Harrisonust/STM32Keyboard/doc/images/keyboard_view.jpg

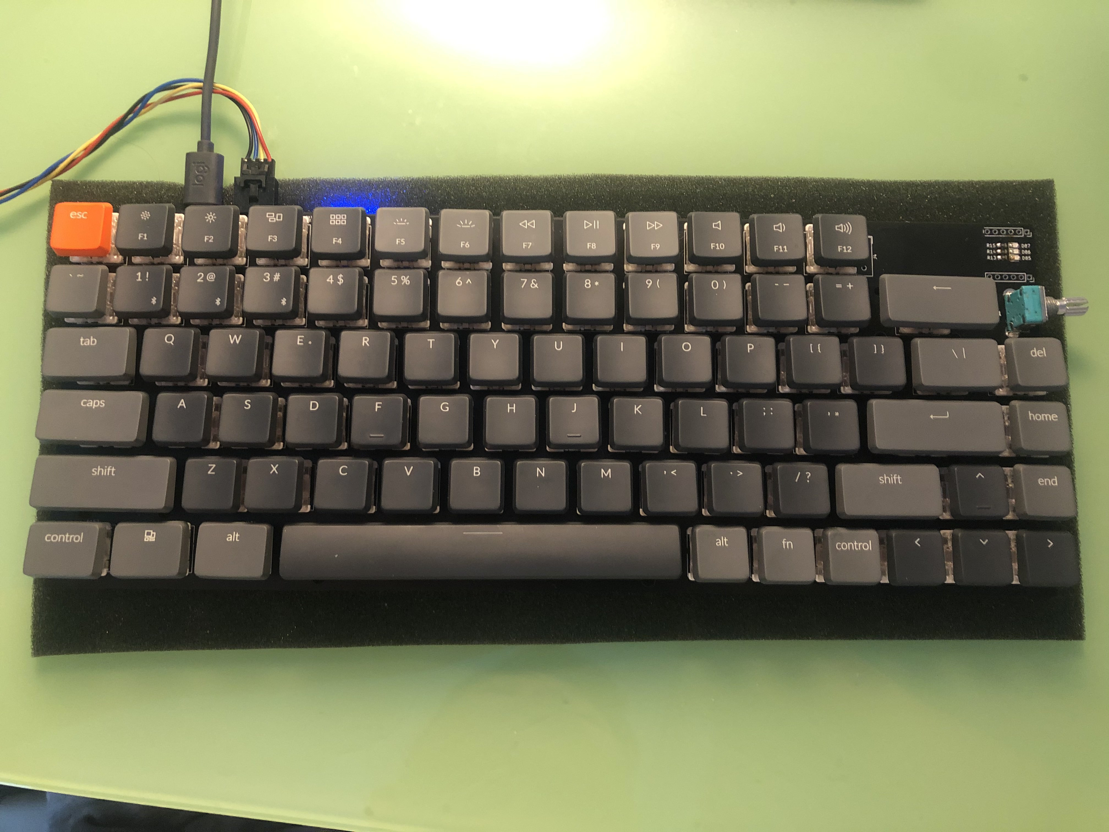
doc/images/keyboard_view.jpg
