Harrisonust/STM32Keyboard/doc/images/kicad-3dview-back.png

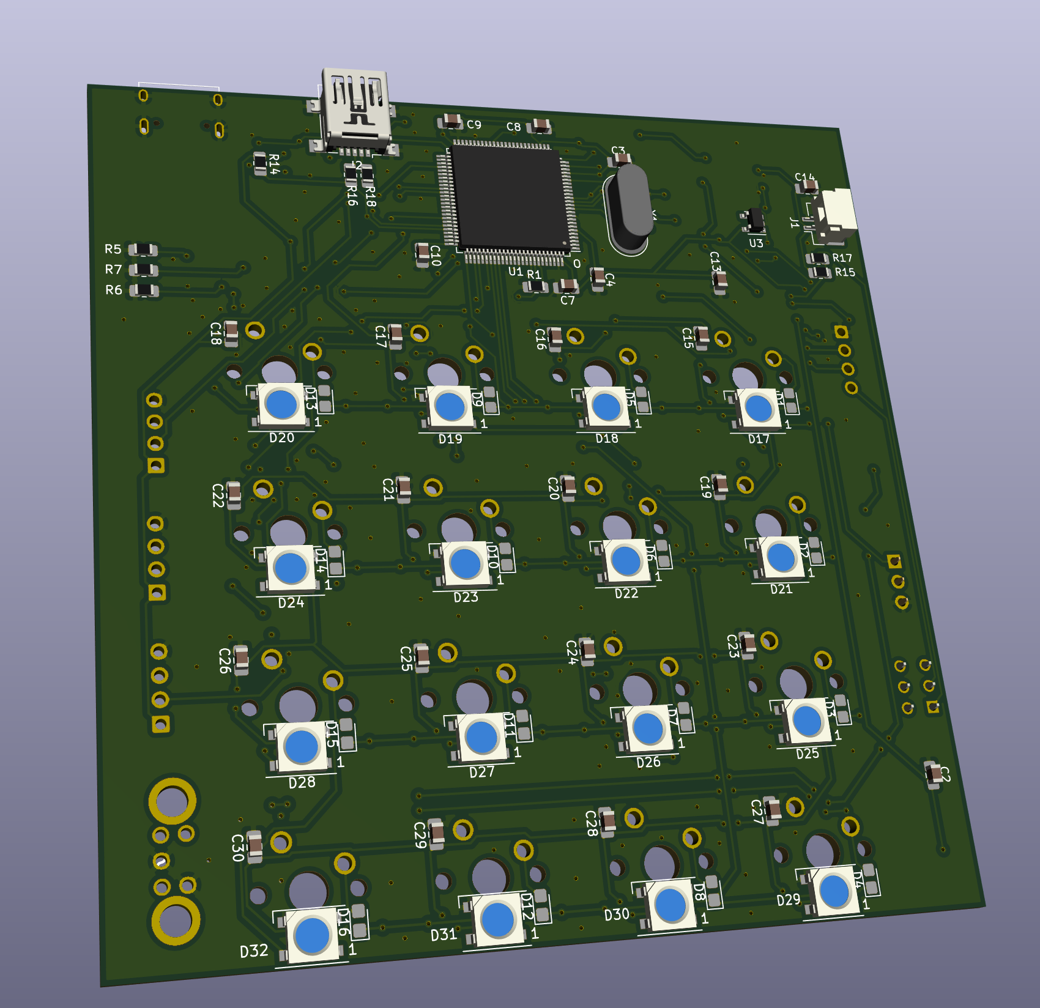
doc/images/kicad-3dview-back.png
