Harrisonust/STM32Keyboard/doc/images/kicad-3dview-front.png

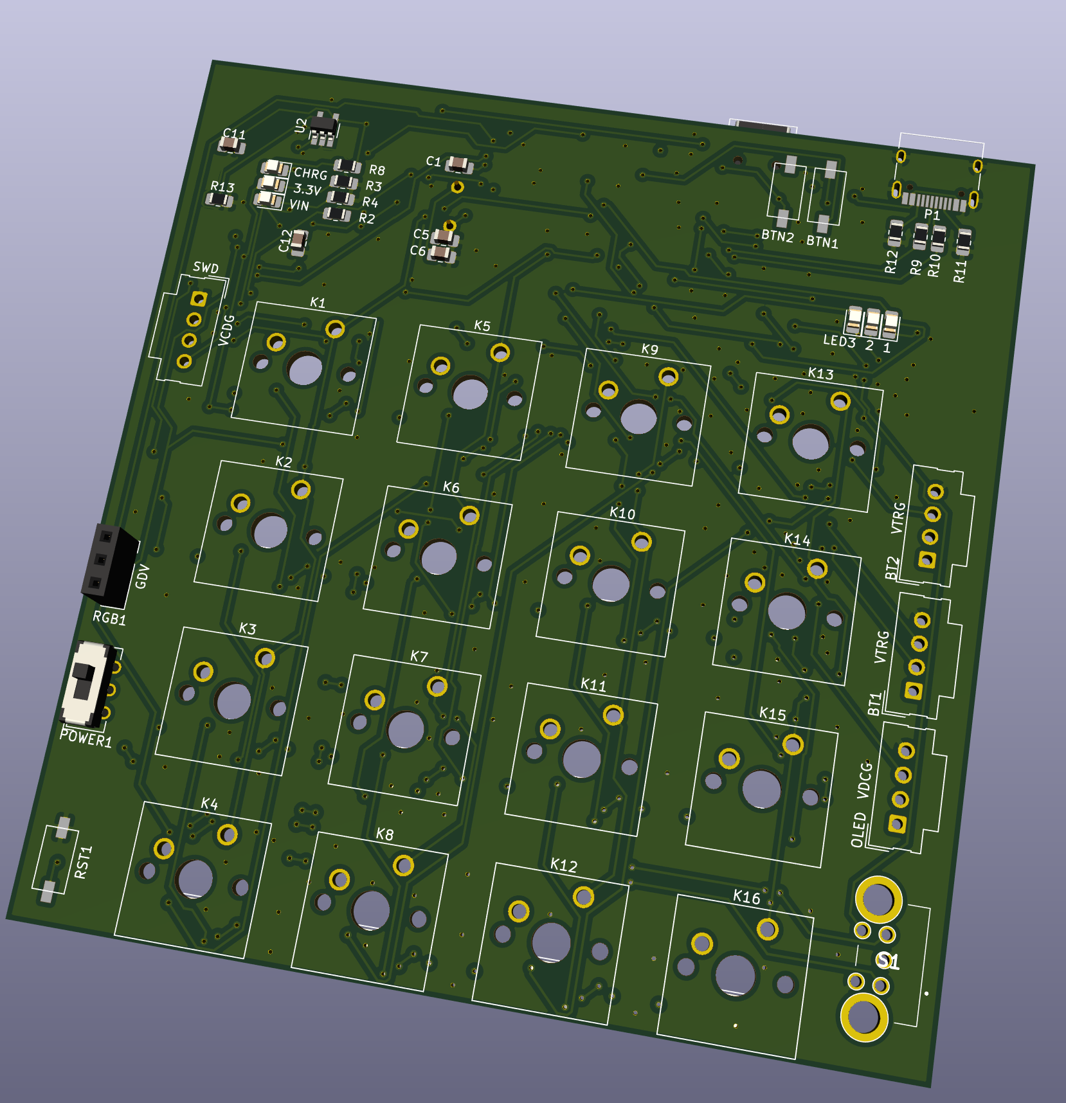
doc/images/kicad-3dview-front.png
