Harrisonust/STM32Keyboard/doc/images/pcb-back.png

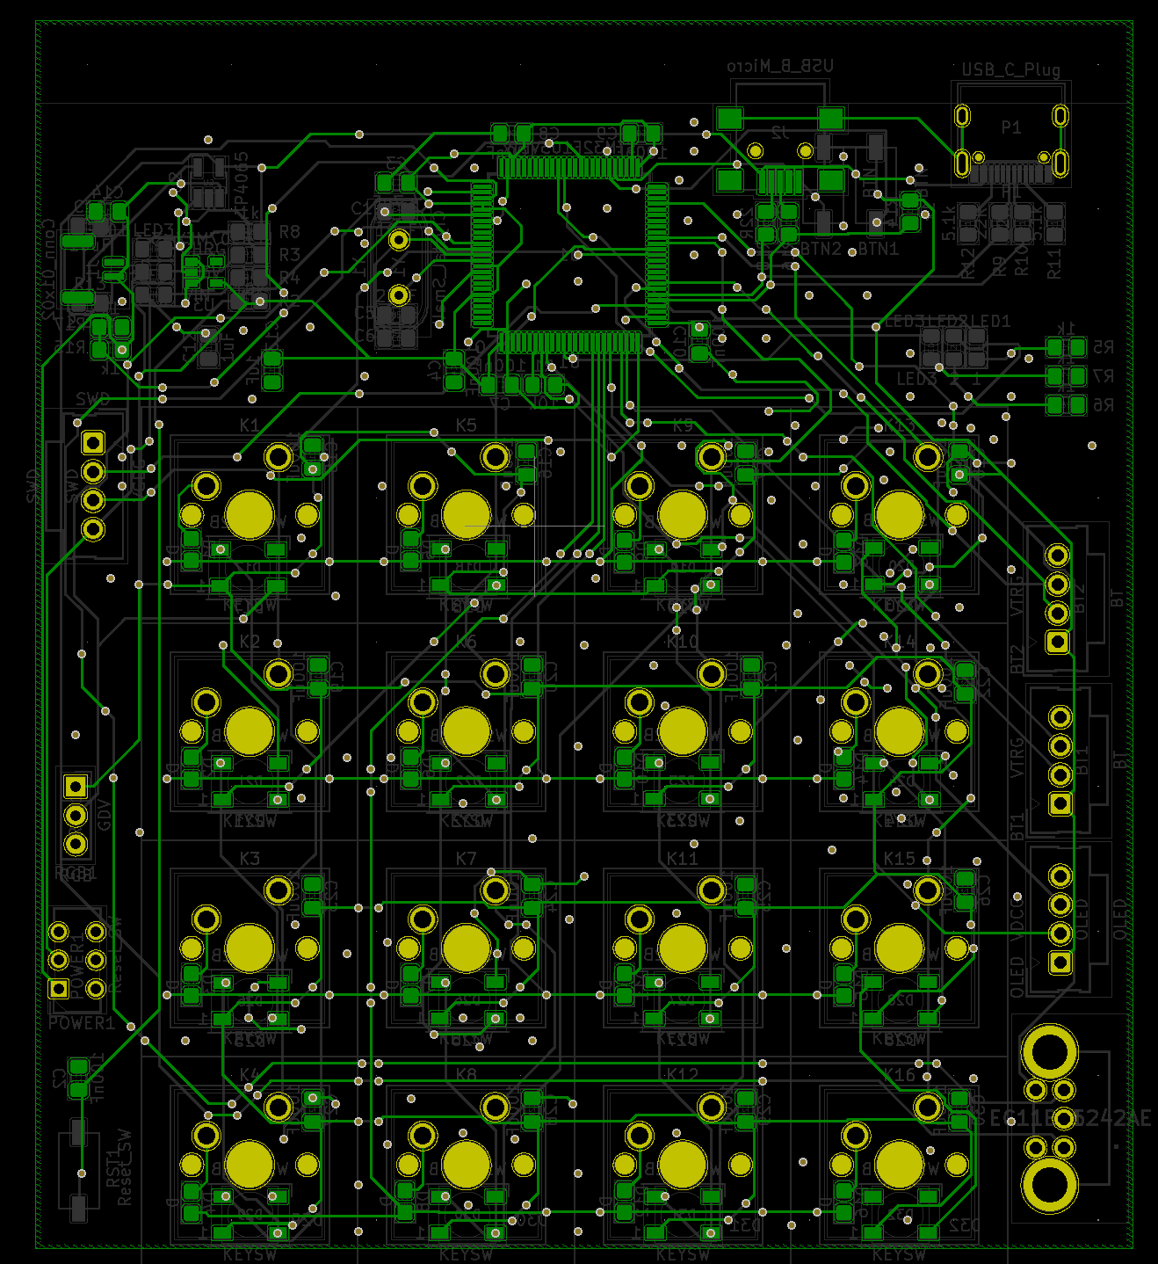
doc/images/pcb-back.png
