Harrisonust/STM32Keyboard/doc/images/pcb-front.png

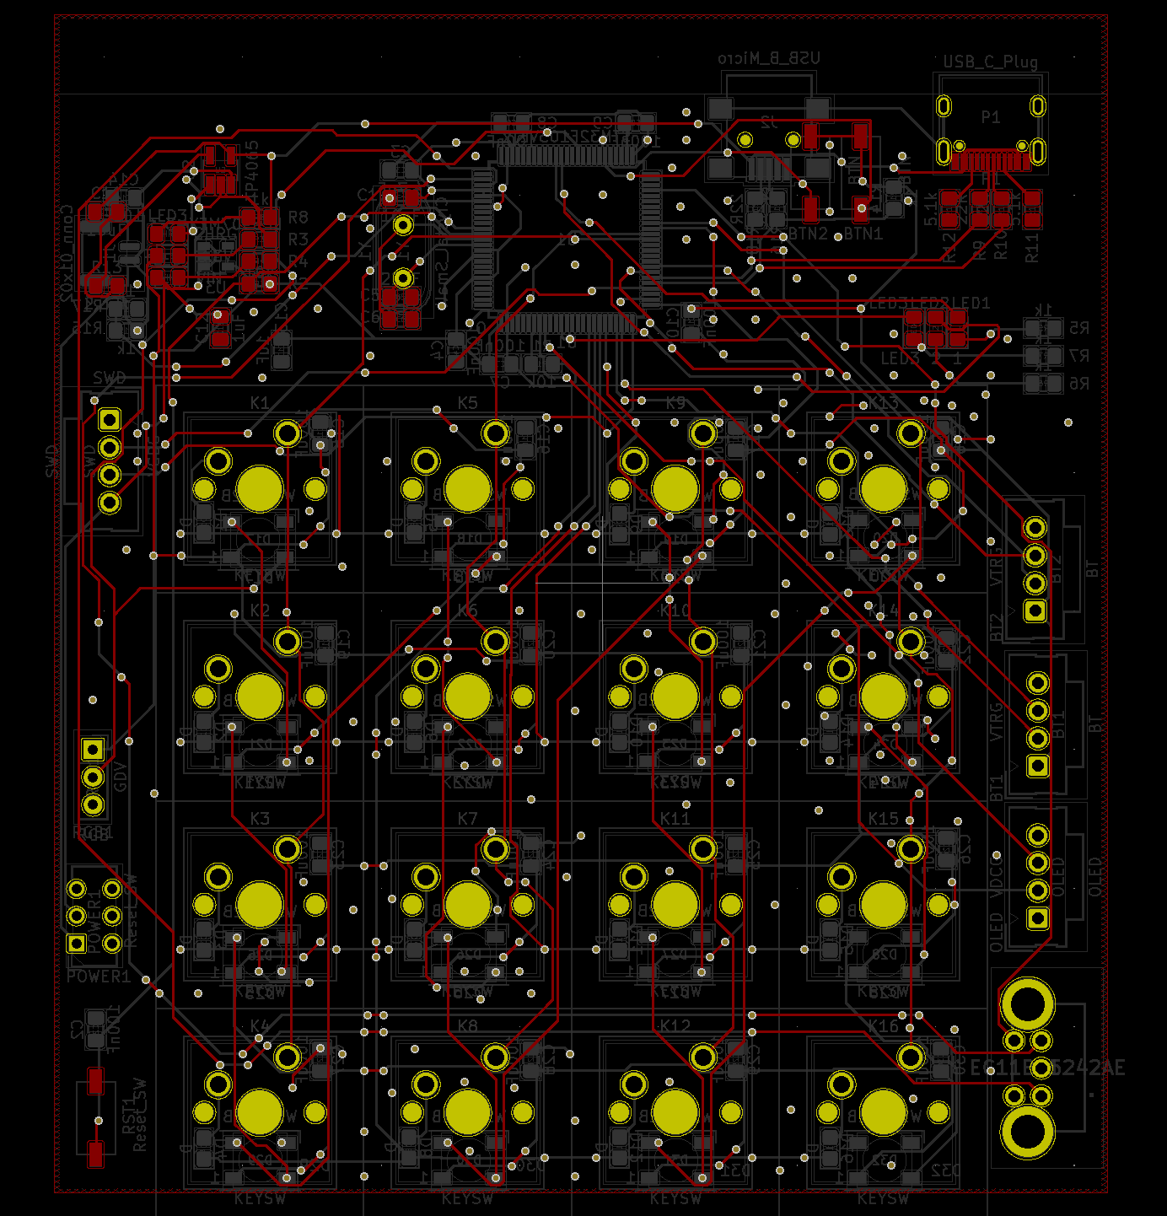
doc/images/pcb-front.png
