Harrisonust/STM32Keyboard/(threads)

Thread 10 (2021-11-21):

fix unstable adc reading of battery problem

Harrisonust, 2021-11-21:

Closed 2021-11-30.

Thread 18 (2021-12-01):

Change to reverse ws2812b footprint

Harrisonust, 2021-12-01:
Buy them and draw pcb

Closed 2022-01-10.
