Harrisonust/STM32Keyboard/doc/mykeyboard.pdf

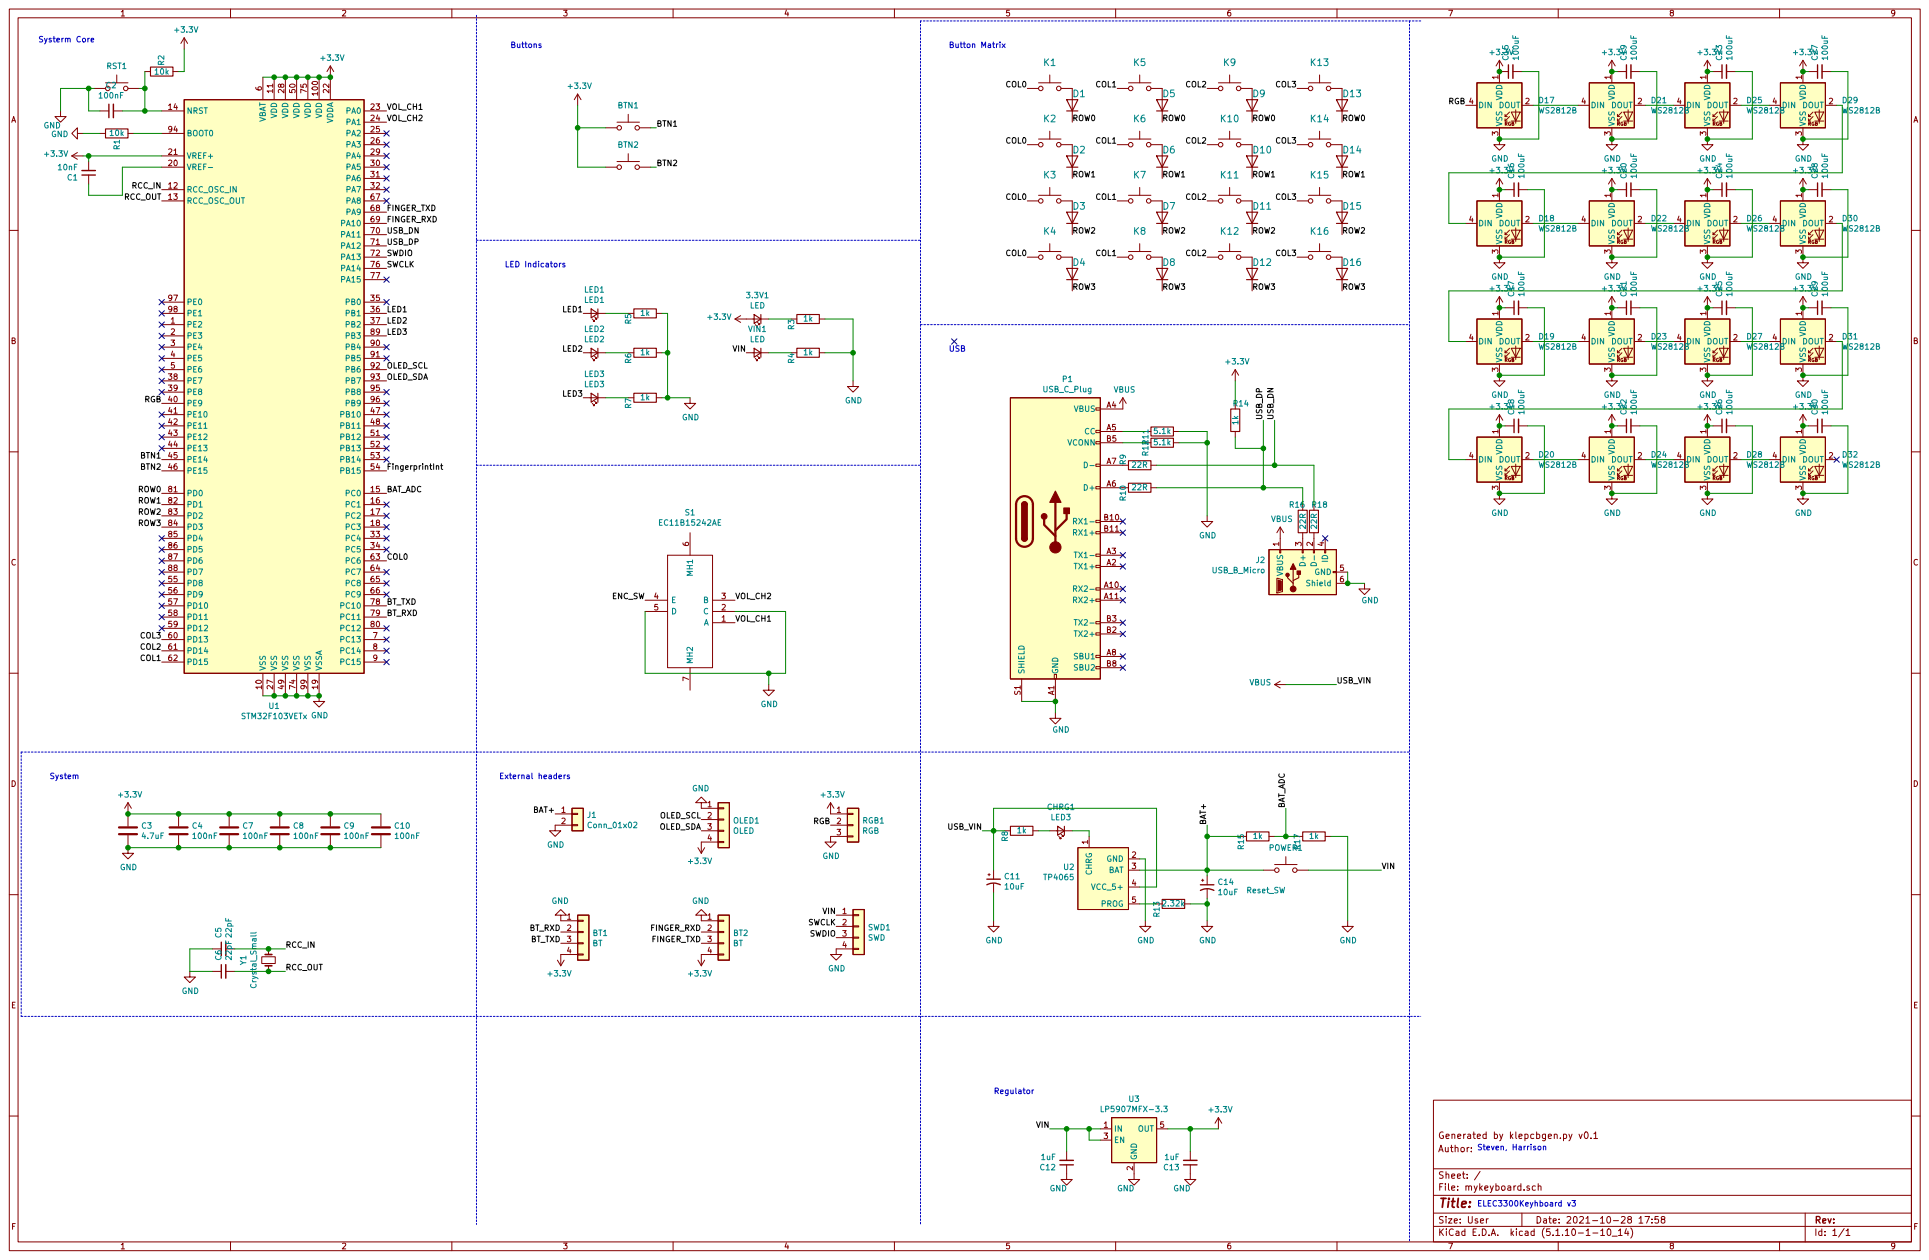
[picture p7: page 1]

LED Indicators Buttons Systerm Core

6 VDD 100 VDD 11 VDD 28 VDD 50 VDD 75 VDDA 22 VREF+ 21 VREF- 20 VSS 10 VSS 27 VSS 49 VSS 74 VSS 99 VSSA 19 U1 STM32F103VETx VBUS GND R125.1k GND A1 RX2- A10 RX2+ A11 TX1+ A2 TX1- A3 VBUS A4 CC A5 D+ A6 D- A7 SBU1 A8 RX1- B10 RX1+ B11 TX2+ B2 TX2- B3 VCONN B5 SBU2 B8 SHIELD S1 P1 USB_C_Plug

1 GND 2 BAT 3 VCC_5+ 4 PROG 5 U2 TP4065 VBUS R9 22R R1022R GND

File: mykeyboard.sch Sheet: / Author: Generated by klepcbgen.py v0.1
