Harrisonust/STM32Keyboard/Core/Src/main.c

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

/* Includes ------------------------------------------------------------------*/
#include "main.h"

#include "cmsis_os.h"
#include "usb_device.h"

/* USER CODE BEGIN Includes */
#include "RGB.h"
#include "battery.h"
#include "display_manager.h"
#include "fingerprint.h"
#include "host_OS.h"
#include "key_handler.h"
#include "matrix_button.h"
#include "oled_manager.h"
#include "ssd1306.h"
#include "volume.h"
/* USER CODE END Includes */

ADC_HandleTypeDef hadc1;

I2C_HandleTypeDef hi2c1;

TIM_HandleTypeDef htim1;
TIM_HandleTypeDef htim2;
DMA_HandleTypeDef hdma_tim1_ch1;

UART_HandleTypeDef huart4;
UART_HandleTypeDef huart1;

osThreadId KeyTaskHandle;
osThreadId OLEDTaskHandle;
osThreadId RGBTaskHandle;
osThreadId debugTaskHandle;
/* USER CODE BEGIN PV */
extern WS2812 ws2812;
/* USER CODE END PV */

void SystemClock_Config(void);
static void MX_GPIO_Init(void);
static void MX_ADC1_Init(void);
static void MX_TIM1_Init(void);
static void MX_I2C1_Init(void);
static void MX_DMA_Init(void);
static void MX_UART4_Init(void);
static void MX_TIM2_Init(void);
static void MX_USART1_UART_Init(void);
void StartUSBTask(void const *argument);
void StartOLEDTask(void const *argument);
void WS2812_LED_Task(void const *argument);
void StartDebugTask(void const *argument);

/**
  * @brief  The application entry point.
  * @retval int
  */
int main(void) {
    /* MCU Configuration--------------------------------------------------------*/

    /* Reset of all peripherals, Initializes the Flash interface and the Systick. */
    HAL_Init();

    /* Configure the system clock */
    SystemClock_Config();

    /* Initialize all configured peripherals */
    MX_GPIO_Init();
    MX_ADC1_Init();
    MX_DMA_Init();
    MX_TIM1_Init();
    MX_I2C1_Init();
    MX_UART4_Init();
    MX_TIM2_Init();
    MX_USART1_UART_Init();
    /* USER CODE BEGIN 2 */
    HAL_ADCEx_Calibration_Start(&hadc1);
    HAL_ADC_Start(&hadc1);
    HAL_TIM_Encoder_Start_IT(&htim2, TIM_CHANNEL_ALL);
    /* USER CODE END 2 */

    /* Create the thread(s) */
    /* definition and creation of KeyTask */
    osThreadDef(KeyTask, StartUSBTask, osPriorityRealtime, 0, 128);
    KeyTaskHandle = osThreadCreate(osThread(KeyTask), NULL);

    /* definition and creation of OLEDTask */
    osThreadDef(OLEDTask, StartOLEDTask, osPriorityIdle, 0, 128);
    OLEDTaskHandle = osThreadCreate(osThread(OLEDTask), NULL);

    /* definition and creation of RGBTask */
    osThreadDef(RGBTask, WS2812_LED_Task, osPriorityIdle, 0, 128);
    RGBTaskHandle = osThreadCreate(osThread(RGBTask), NULL);

    /* definition and creation of debugTask */
    osThreadDef(debugTask, StartDebugTask, osPriorityIdle, 0, 128);
    debugTaskHandle = osThreadCreate(osThread(debugTask), NULL);

    /* Start scheduler */
    osKernelStart();

    /* We should never get here as control is now taken by the scheduler */

    /* Infinite loop */
}

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
void StartUSBTask(void const *argument) {
    /* init code for USB_DEVICE */
    MX_USB_DEVICE_Init();

    /* USER CODE BEGIN 5 */
    /* Infinite loop */
    HAL_GPIO_WritePin(USB_EN_GPIO_Port, USB_EN_Pin, 0);

    key_thread();
    /* USER CODE END 5 */
}

/* USER CODE BEGIN Header_StartOLEDTask */
uint32_t last_keyinterrupt_tick = 0;
uint32_t SLEEPMODE_TIMEOUT = 10000;
uint8_t ssd_do_once_flag = 1;
uint8_t sleep_mode = 0;
extern KEYBOARD_OPERATION_MODE keyboard_operation_mode;
uint32_t oled_tick = 0;
uint8_t send_password_flag = 0;

void HAL_GPIO_EXTI_Callback(uint16_t GPIO_Pin) {
    // if (GPIO_Pin == ROW0_Pin || GPIO_Pin == ROW1_Pin || GPIO_Pin == ROW2_Pin ||
    //     GPIO_Pin == ROW3_Pin) {
    //     last_keyinterrupt_tick = HAL_GetTick();
    //     sleep_mode = 0;
    //     ssd_do_once_flag = 1;
    // }
    // if (GPIO_Pin == FINGERPRINT_INT_Pin) {
    //     if (keyboard_operation_mode == KEYBOARD_OPERATION_MODE_NORMAL) {
    //         uint8_t result = check_fingerprint();
    //         if (result == 0) {
    //             led_mode(0);
    //             send_password_flag = 1;
    //             led_mode(1);
    //         }
    //     }
    // }
}
/**
* @brief Function implementing the OLEDTask thread.
* @param argument: Not used
* @retval None
*/
/* USER CODE END Header_StartOLEDTask */
void StartOLEDTask(void const *argument) {
    /* USER CODE BEGIN StartOLEDTask */
    ssd1306_Init();
    display_manager_init();
    for (;;) {
        // ssd1306_WriteChar('A', Font_16x26, 0x01);
        // if (send_password_flag) {
        //     send_password();
        //     send_password_flag = 0;
        // }
        // if (HAL_GetTick() - last_keyinterrupt_tick > SLEEPMODE_TIMEOUT) {
        //     sleep_mode = 1;
        // }

        // if (sleep_mode)
        //     ssd1306_SetDisplayOn(0);
        // else {
        //     if (ssd_do_once_flag) {
        //         ssd1306_SetDisplayOn(1);
        //         ssd_do_once_flag = 0;
        //     }
        //     if (HAL_GetTick() - oled_tick > 1000 &&
        //         keyboard_operation_mode == KEYBOARD_OPERATION_MODE_NORMAL) {
        //         oled_update_page();
        //         oled_tick = HAL_GetTick();
        //     }
        // }
        // if (button_read(&b))
        //     b.button_clicked_listener(&b, BUTTON_CLICKED);
        // else
        //     b.button_released_listener(&b, BUTTON_RELEASED);
        // ssd1306_WriteString("Hello", Font_6x8, 0x01);
        display_manager_update();
        osDelay(100);
    }
    /* USER CODE END StartOLEDTask */
}

/* USER CODE BEGIN Header_WS2812_LED_Task */
/**
* @brief Function implementing the RGBTask thread.
* @param argument: Not used
* @retval None
*/
extern uint32_t brightness;  // range from 0(nolight) to 99(full)
extern uint8_t speed;        // range from 0(slowest) to 99(fastest)
extern WS2812Mode rgb_mode;
/* USER CODE END Header_WS2812_LED_Task */
void WS2812_LED_Task(void const *argument) {
    /* USER CODE BEGIN WS2812_LED_Task */
    WS2812_InitStruct ws2812_initStruct = {.LED_num = MAX_LED, .tim = &htim1, .channel = TIM_CHANNEL_1};
    WS2812_init(&ws2812, &ws2812_initStruct);

    for (;;) {
        // if (sleep_mode) {
        //     rgb_mode = WS2812DISABLE;
        // }
        WS2812_LED_SetBrightness(&ws2812, brightness);
        switch (rgb_mode) {
        case LOOPMODE:
            WS2812_Loop_Pattern(&ws2812);
            break;
        case BREATHMODE:
            WS2812_Breath_Pattern(&ws2812);
            break;
        case STATICMODE:
            WS2812_Static_Pattern(&ws2812);
            break;
        case LAYEREDMODE:
            WS2812_Layered_Pattern(&ws2812);
            break;
        case STATICBREATHMODE:
            WS2812_Monotonic_Breate_Pattern(&ws2812);
            break;
        case THEMATRIXMODE:
            WS2812_The_Matrix_Hor_Pattern(&ws2812);
            break;
        case WS2812DISABLE:
        default:
            WS2812_TurnOff_Pattern(&ws2812);
            break;
        }
        WS2812_sendData(&ws2812);
        speed = constrain(speed, 0, 99);
        osDelay(200 * (1 - speed / 100.0));
    }
    WS2812_Deinit(&ws2812);
    /* USER CODE END WS2812_LED_Task */
}

/* USER CODE BEGIN Header_StartDebugTask */
/**
* @brief Function implementing the debugTask thread.
* @param argument: Not used
* @retval None
*/
/* USER CODE END Header_StartDebugTask */
void StartDebugTask(void const *argument) {
    /* USER CODE BEGIN StartDebugTask */
    /* Infinite loop */
    for (;;) {
        HAL_GPIO_WritePin(LED2_GPIO_Port, LED2_Pin, 0);
        osDelay(100);
        HAL_GPIO_WritePin(LED2_GPIO_Port, LED2_Pin, 1);
        osDelay(100);

        if(HAL_GPIO_ReadPin(ENC_SW_GPIO_Port, ENC_SW_Pin))
            HAL_GPIO_WritePin(LED1_GPIO_Port, LED1_Pin, 0);
        else
            HAL_GPIO_WritePin(LED1_GPIO_Port, LED1_Pin, 1);
    }
    /* USER CODE END StartDebugTask */
}

/**
  * @brief  Period elapsed callback in non blocking mode
  * @note   This function is called  when TIM6 interrupt took place, inside
  * HAL_TIM_IRQHandler(). It makes a direct call to HAL_IncTick() to increment
  * a global variable "uwTick" used as application time base.
  * @param  htim : TIM handle
  * @retval None
  */
void HAL_TIM_PeriodElapsedCallback(TIM_HandleTypeDef *htim) {
    if (htim->Instance == TIM6) {
        HAL_IncTick();
    }
}

/**
  * @brief  This function is executed in case of error occurrence.
  * @retval None
  */
void Error_Handler(void) {
}

#ifdef USE_FULL_ASSERT
/**
  * @brief  Reports the name of the source file and the source line number
  *         where the assert_param error has occurred.
  * @param  file: pointer to the source file name
  * @param  line: assert_param error line source number
  * @retval None
  */
void assert_failed(uint8_t *file, uint32_t line) {
}
#endif /* USE_FULL_ASSERT */

/************************ (C) COPYRIGHT STMicroelectronics *****END OF FILE****/
