Harrisonust/STM32Keyboard/Core/Inc/main.h

#define BAT_ADC_Pin GPIO_PIN_0
#define BAT_ADC_GPIO_Port GPIOC
#define VOL_CH1_Pin GPIO_PIN_0
#define VOL_CH1_GPIO_Port GPIOA
#define VOL_CH2_Pin GPIO_PIN_1
#define VOL_CH2_GPIO_Port GPIOA
#define ENC_SW_Pin GPIO_PIN_2
#define ENC_SW_GPIO_Port GPIOA
#define LED1_Pin GPIO_PIN_1
#define LED1_GPIO_Port GPIOB
#define LED2_Pin GPIO_PIN_2
#define LED2_GPIO_Port GPIOB
#define RGB_Pin GPIO_PIN_9
#define RGB_GPIO_Port GPIOE
#define COL13_Pin GPIO_PIN_11
#define COL13_GPIO_Port GPIOE
#define COL12_Pin GPIO_PIN_12
#define COL12_GPIO_Port GPIOE
#define BTN1_Pin GPIO_PIN_14
#define BTN1_GPIO_Port GPIOE
#define BTN2_Pin GPIO_PIN_15
#define BTN2_GPIO_Port GPIOE
#define COL11_Pin GPIO_PIN_12
#define COL11_GPIO_Port GPIOB
#define COL10_Pin GPIO_PIN_13
#define COL10_GPIO_Port GPIOB
#define COL9_Pin GPIO_PIN_14
#define COL9_GPIO_Port GPIOB
#define FINGERPRINT_INT_Pin GPIO_PIN_15
#define FINGERPRINT_INT_GPIO_Port GPIOB
#define FINGERPRINT_INT_EXTI_IRQn EXTI15_10_IRQn
#define COL8_Pin GPIO_PIN_8
#define COL8_GPIO_Port GPIOD
#define COL7_Pin GPIO_PIN_9
#define COL7_GPIO_Port GPIOD
#define COL6_Pin GPIO_PIN_10
#define COL6_GPIO_Port GPIOD
#define COL5_Pin GPIO_PIN_11
#define COL5_GPIO_Port GPIOD
#define COL4_Pin GPIO_PIN_12
#define COL4_GPIO_Port GPIOD
#define COL3_Pin GPIO_PIN_13
#define COL3_GPIO_Port GPIOD
#define COL2_Pin GPIO_PIN_14
#define COL2_GPIO_Port GPIOD
#define COL1_Pin GPIO_PIN_15
#define COL1_GPIO_Port GPIOD
#define COL0_Pin GPIO_PIN_6
#define COL0_GPIO_Port GPIOC
#define FINGER_TXD_Pin GPIO_PIN_9
#define FINGER_TXD_GPIO_Port GPIOA
#define FINGER_RXD_Pin GPIO_PIN_10
#define FINGER_RXD_GPIO_Port GPIOA
#define USB_DN_Pin GPIO_PIN_11
#define USB_DN_GPIO_Port GPIOA
#define BT_TXD_Pin GPIO_PIN_10
#define BT_TXD_GPIO_Port GPIOC
#define BT_RXD_Pin GPIO_PIN_11
#define BT_RXD_GPIO_Port GPIOC
#define ROW0_Pin GPIO_PIN_0
#define ROW0_GPIO_Port GPIOD
#define ROW0_EXTI_IRQn EXTI0_IRQn
#define ROW1_Pin GPIO_PIN_1
#define ROW1_GPIO_Port GPIOD
#define ROW1_EXTI_IRQn EXTI1_IRQn
#define ROW2_Pin GPIO_PIN_2
#define ROW2_GPIO_Port GPIOD
#define ROW2_EXTI_IRQn EXTI2_IRQn
#define ROW3_Pin GPIO_PIN_3
#define ROW3_GPIO_Port GPIOD
#define ROW3_EXTI_IRQn EXTI3_IRQn
#define ROW4_Pin GPIO_PIN_4
#define ROW4_GPIO_Port GPIOD
#define ROW5_Pin GPIO_PIN_5
#define ROW5_GPIO_Port GPIOD
#define USB_EN_Pin GPIO_PIN_6
#define USB_EN_GPIO_Port GPIOD
#define LED3_Pin GPIO_PIN_3
#define LED3_GPIO_Port GPIOB
#define OLED_SCL_Pin GPIO_PIN_6
#define OLED_SCL_GPIO_Port GPIOB
#define OLED_SDA_Pin GPIO_PIN_7
#define OLED_SDA_GPIO_Port GPIOB
