Harrisonust/STM32Keyboard/Core/Src/volume.c

/*
 * volume.c
 *
 *  Created on: Nov 10, 2021
 *      Author: luoshiheng
 */

#include "volume.h"

#include "HID_code.h"
#include "hid_queue.h"
#include "host_OS.h"
#include "key_handler.h"

extern TIM_HandleTypeDef htim2;

void encoder_init() {
    htim2.Instance->CNT = 0xffff / 2;
}

int32_t vol_counter = 0;
int32_t prev_vol_counter = 0;
void HAL_TIM_IC_CaptureCallback(TIM_HandleTypeDef *htim) {
    vol_counter = __HAL_TIM_GET_COUNTER(htim) / ENCODER_STEP;
}

/**
 * TODO: having some bugs in encoder it is too sensitive
 */

Volume_State update_volume() {
    if (vol_counter > prev_vol_counter)
        return VOLUME_UP;
    else if (vol_counter < prev_vol_counter)
        return VOLUME_DOWN;
    else
        return VOLUME_NO_ACTION;
}

extern OS_TYPE OS_type;
extern HID_Queue hid_queue;
void volume_handler() {
    Volume_State vol_state = update_volume();
    if (vol_state == VOLUME_DOWN) {
        if (OS_type == OS_MAC)
            push(&hid_queue, 0x80);
        if (OS_type == OS_LINUX)
            push(&hid_queue, KEY_F12);  //volume up
    } else if (vol_state == VOLUME_UP) {
        if (OS_type == OS_MAC)
            push(&hid_queue, 0x81);
        if (OS_type == OS_LINUX)
            push(&hid_queue, KEY_F11);  //volume down
    } else if (vol_state == VOLUME_NO_ACTION) {
    }
    prev_vol_counter = vol_counter;
}
