Harrisonust/STM32Keyboard/(commit log)

2021-10-27 add gitignore
    [Elec3300Keyboard Debug.cfg]
2021-11-02 finish rtos and add more pin configurations(cube gui setting)
    [testing.cfg]
2021-11-06 key matrix work on pcb
2021-11-07 added intergraton of LED between ws2812
2021-11-07 shifted some adc values
2021-11-10 hid work on lab board
2021-11-10 done encoder
2021-11-16 clean button matrix lib and enable interrupt
2021-11-18 have some minor bug when long press the button but i still push it anyway:
    [keyInterface.c]
2021-11-18 added fingerprint library
2021-11-22 Fingerprint working
2021-11-22 finger print interrupt
2021-11-22 fingrtprint interrupt
2021-11-22 encoder buggy
2021-11-22 fix encoder
2021-11-26 Fixed macro and added oled_page_init
    [keyInterface.c]
2021-11-27 fingerprint paswword
2021-11-27 fix the rgb bug
    [RGB.c, RGB.h, main.c]
2021-12-24 cmake work
    [stm32f1x.cfg]
2021-12-24 USB_DEVICE_Init having some bug but kind of fix?
    [stm32f1.cfg]
2021-12-25 OOP on buttons!
2022-01-10 comment out some of the buggy keys add debug config
    [keyInterface.c]
2022-01-10 two of the row pins are not pulled down, now fixed
    [Elec3300Keyboard.ioc, main.c]
2022-01-11 update keycode, modify switch os function
2022-01-18 dealing with on board oled
2022-01-19 add rgb pattern, binding stuff to fn key
    [RGB.c, RGB.h, key_handler.c]
2022-01-23 rename threads
2022-01-23 fix long press hid report bug
    [key_handler.c, key_handler.h, volume.c]
2022-01-23 change key thread priority
2022-10-16 remove useless files
    [stm32f1.cfg]
2022-10-16 10/16 debug on new pcb
